potpurri/PPS-power-supply/PPS-Power-Supply.kicad_pcb

## KiCad design PPS-Power-Supply.kicad_pcb (2026-04-08)

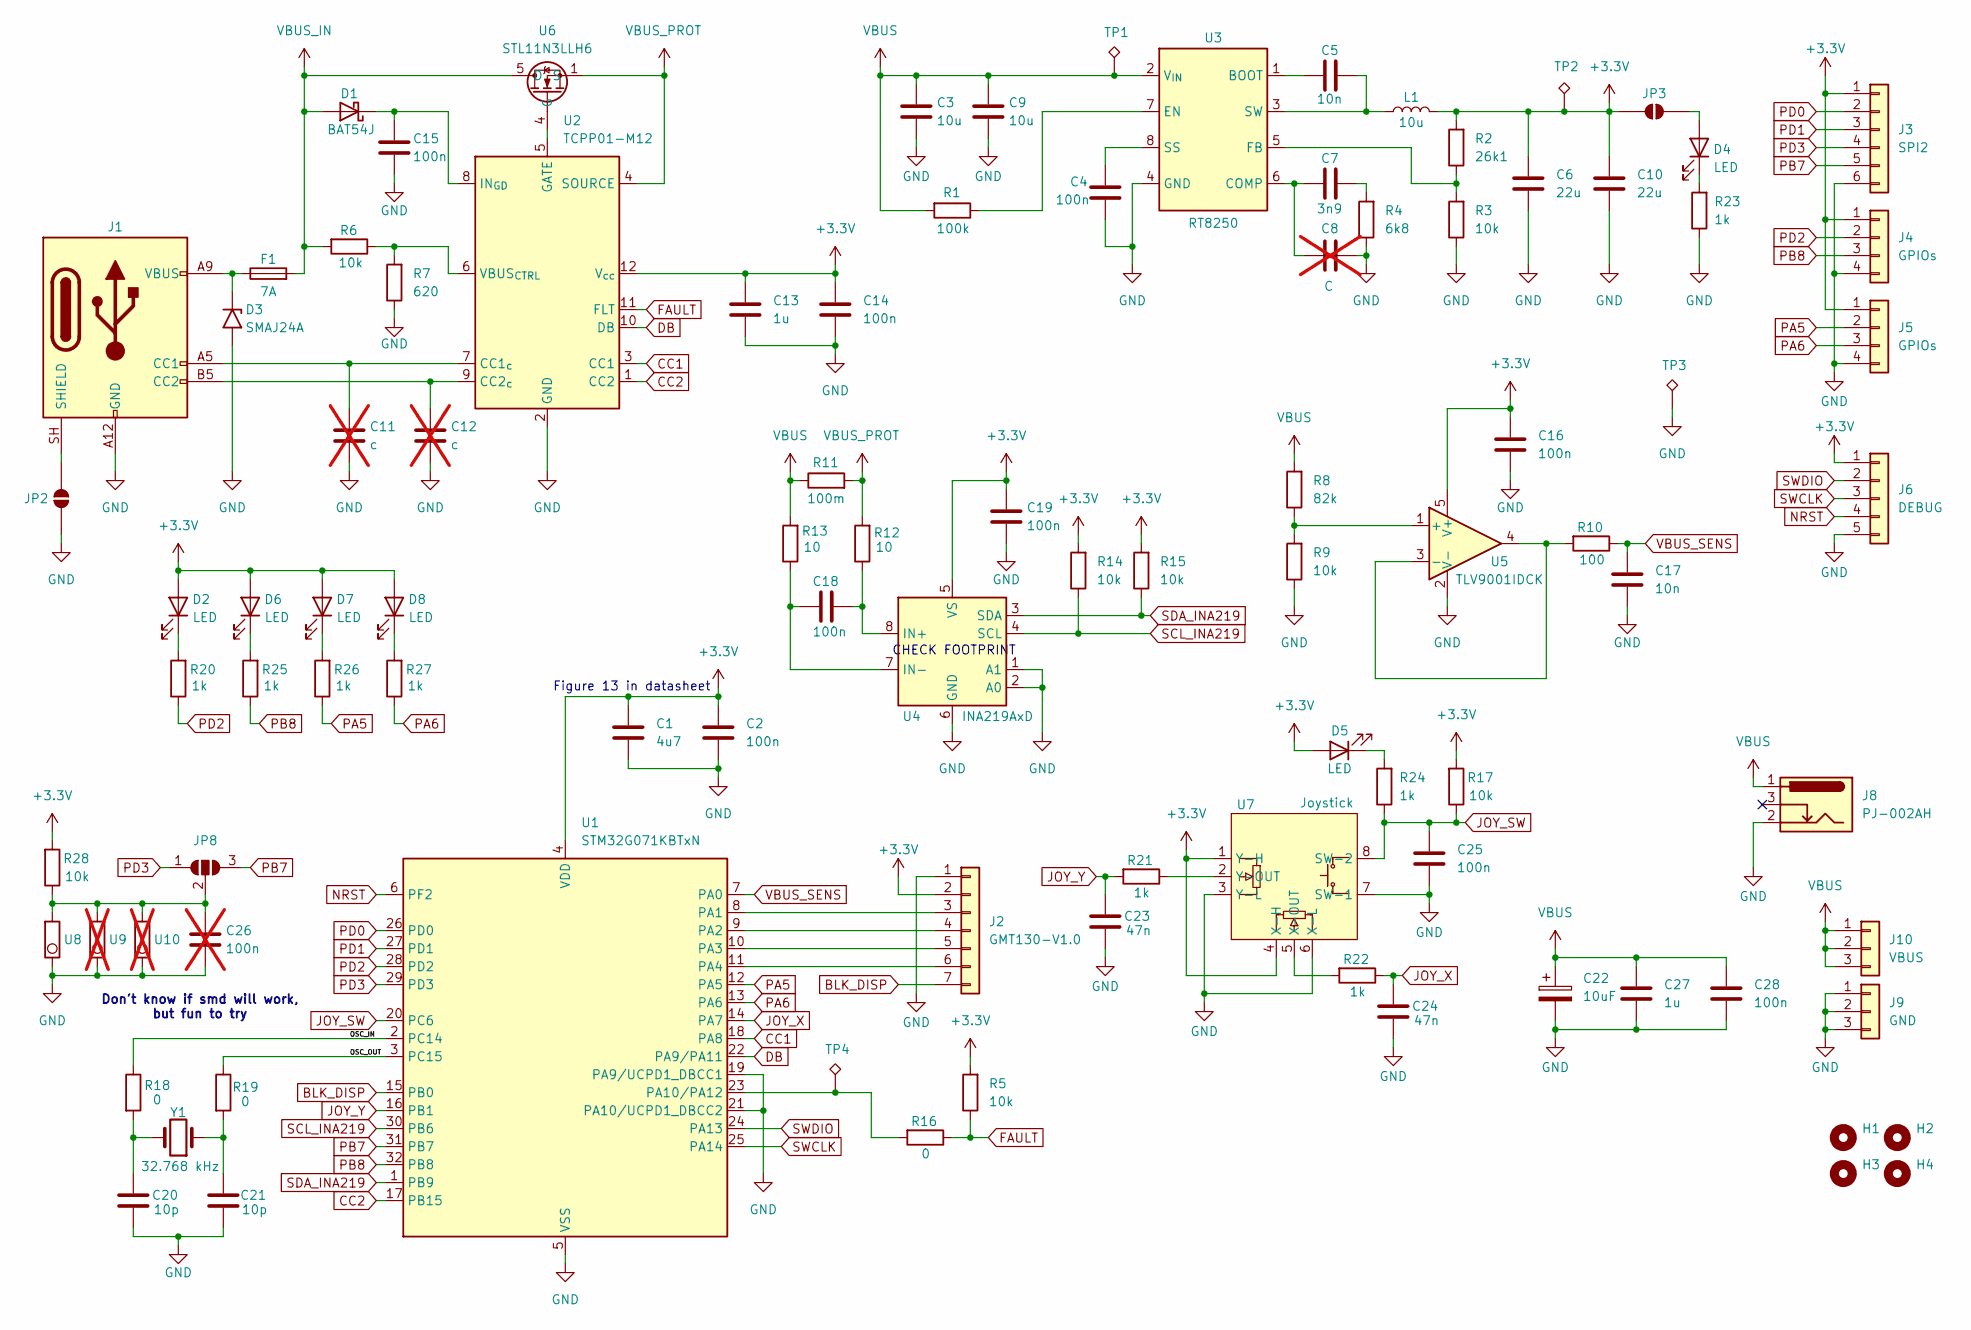
[picture p1: schematic PPS-Power-Supply.kicad_sch]

Parts:
C1: 4u7; C_0805_2012Metric
C2, C4, C14, C15, C16, C18, C19, C25, C28: 100n; C_0603_1608Metric
C3, C9: 10u; C_1206_3216Metric
C5, C17: 10n; C_0603_1608Metric
C6, C10: 22u; C_1206_3216Metric
C7: 3n9; C_0603_1608Metric
C8: C; C_0603_1608Metric; not fitted
C11, C12: c; C_0603_1608Metric; not fitted
C13, C27: 1u; C_0805_2012Metric
C20, C21: 10p; C_0603_1608Metric
C22: 10uF; CP_Elec_5x5.3
C23, C24: 47n; C_0603_1608Metric
C26: 100n; C_0603_1608Metric; not fitted
D1: BAT54J; D_SOD-323F
D2, D4, D5, D6, D7, D8: LED; LED_0805_2012Metric
D3: SMAJ24A; D_SMB
F1: 7A; Fuse_1206_3216Metric
H1, H2, H3, H4: MountingHole; MountingHole_3.2mm_M3_DIN965_Pad_TopBottom
J1: USB_C_Receptacle_PowerOnly_6P; USB_C_Receptacle_HRO_TYPE-C-31-M-17
J2: GMT130-V1.0; PinHeader_1x07_P2.54mm_Vertical
J3: SPI2; PinHeader_1x06_P2.54mm_Vertical
J4, J5: GPIOs; PinHeader_1x04_P2.54mm_Vertical
J6: DEBUG; PinHeader_1x05_P2.54mm_Vertical
J8: PJ-002AH; BarrelJack_GCT_DCJ200-10-A_Horizontal
J9: GND; PinHeader_1x03_P2.54mm_Vertical
J10: VBUS; PinHeader_1x03_P2.54mm_Vertical
JP2, JP3: SolderJumper_2_Open; SolderJumper-2_P1.3mm_Open_RoundedPad1.0x1.5mm
JP8: SolderJumper_3_Open; SolderJumper-3_P1.3mm_Open_RoundedPad1.0x1.5mm
L1: 10u; L_APV_ANR5020
R1: 100k; R_0603_1608Metric
R2: 26k1; R_0603_1608Metric
R3, R5, R6, R9, R14, R15, R17, R28: 10k; R_0603_1608Metric
R4: 6k8; R_0603_1608Metric
R7: 620; R_0603_1608Metric
R8: 82k; R_0603_1608Metric
R10: 100; R_0603_1608Metric
R11: 100m; R_2512_6332Metric
R12, R13: 10; R_0603_1608Metric
R16, R18, R19: 0; R_0805_2012Metric
R20, R21, R22, R23, R24, R25, R26, R27: 1k; R_0603_1608Metric
TP1, TP2, TP3, TP4: TestPoint_Alt; TestPoint_Pad_D1.0mm
U1: STM32G071KBTxN; LQFP-32_7x7mm_P0.8mm
U2: TCPP01-M12; QFN-12-1EP_3x3mm_P0.5mm_EP1.45x1.45mm
U3: RT8250; Texas_HSOP-8-1EP_3.9x4.9mm_P1.27mm
U4: INA219AxD; SOIC-8_3.9x4.9mm_P1.27mm
U5: TLV9001IDCK; SOT-353_SC-70-5
U6: STL11N3LLH6; POWERFLAT-3p3X3p3_STM
U7: Joystick
U8: R_Axial_DIN0411_L9.9mm_D3.6mm_P15.24mm_Horizontal
U9, U10: L_1210_3225Metric; not fitted
Y1: 32.768 kHz; Crystal_SMD_3215-2Pin_3.2x1.5mm

Connections:
+3.3V: C1.1, C2.1, C6.1, C10.1, C13.1, C14.1, C16.1, C19.1, D2.2 (A), D5.2 (A), D6.2 (A), D7.2 (A), D8.2 (A), J2.2, J3.1, J4.1, J5.1, J6.1, JP3.1 (A), L1.2, R2.2, R5.2, R14.2, R15.2, R17.2, R28.2, TP2.1 (1_1), U1.4 (VDD), U2.12 (V_{cc}), U4.5 (VS), U5.5 (V+), U7.1 (Y-H), U7.4 (X-H)
/OSC_IN: R18.1, U1.2 (PC14)
/OSC_OUT: R19.1, U1.3 (PC15)
BLK_DISP: J2.7, U1.15 (PB0)
CC1: U1.18 (PA8), U2.3 (CC1)
CC2: U1.17 (PB15), U2.1 (CC2)
DB: U1.22 (PA9/PA11), U2.10 (DB)
FAULT: R5.1, R16.1, U2.11 (FLT)
GND: C1.2, C2.2, C3.2, C4.2, C6.2, C8.2, C9.2, C10.2, C11.2, C12.2, C13.2, C14.2, C15.2, C16.2, C17.2, C19.2, C20.2, C21.2, C22.2, C23.2, C24.2, C25.2, C26.2, C27.2, C28.2, D3.2 (A2), J1.A12 (GND), J1.B12 (GND), J2.1, J3.6, J4.4, J5.4, J6.5, J8.2, J9.1, J9.2, J9.3, JP2.1 (A), R3.1, R4.1, R7.1, R9.1, R23.1, TP3.1 (1_1), U1.5 (VSS), U1.19 (PA9/UCPD1_DBCC1), U1.21 (PA10/UCPD1_DBCC2), U2.2 (GND), U2.13 (GND), U3.4 (GND), U3.9 (GND), U4.1 (A1), U4.2 (A0), U4.6 (GND), U5.2 (V-), U7.3 (Y-L), U7.6 (X-L), U7.7 (SW-1), U8., U8.1, U9., U9.1, U10., U10.1
JOY_SW: C25.1, R17.1, R24.1, U1.20 (PC6), U7.8 (SW-2)
JOY_X: C24.1, R22.1, U1.14 (PA7)
JOY_Y: C23.1, R21.2, U1.16 (PB1)
NRST: J6.4, U1.6 (PF2)
unnamed: C7.2, R4.2
unnamed: C20.1, R18.2, Y1.2
unnamed: C21.1, R19.2, Y1.1
unnamed: C15.1, D1.1 (K), U2.8 (IN_{GD})
unnamed: D2.1 (K), R20.2
unnamed: D3.1 (A1), F1.1, J1.A9 (VBUS), J1.B9 (VBUS)
unnamed: D4.2 (A), JP3.2 (B)
unnamed: D4.1 (K), R23.2
unnamed: D5.1 (K), R24.2
unnamed: D6.1 (K), R25.2
unnamed: D7.1 (K), R26.2
unnamed: D8.1 (K), R27.2
unnamed: C11.1, J1.A5 (CC1), U2.7 (CC1_{c})
unnamed: C12.1, J1.B5 (CC2), U2.9 (CC2_{c})
unnamed: J1.SH (SHIELD), JP2.2 (B)
unnamed: J2.3, U1.8 (PA1)
unnamed: J2.4, U1.9 (PA2)
unnamed: J2.5, U1.10 (PA3)
unnamed: J2.6, U1.11 (PA4)
unnamed: C26.1, JP8.2 (C), R28.1, U8., U8.2, U9., U9.2, U10., U10.2
unnamed: R16.2, TP4.1 (1_1), U1.23 (PA10/PA12)
unnamed: U2.5 (GATE), U6.4 (G)
unnamed: R6.1, R7.2, U2.6 (VBUS_{CTRL})
unnamed: C5.1, U3.1 (BOOT)
unnamed: C7.1, C8.1, U3.6 (COMP)
unnamed: R1.1, U3.7 (EN)
unnamed: R2.1, R3.2, U3.5 (FB)
unnamed: C4.1, U3.8 (SS)
unnamed: C5.2, L1.1, U3.3 (SW)
unnamed: C18.1, R12.1, U4.8 (IN+)
unnamed: C18.2, R13.1, U4.7 (IN-)
unnamed: R8.1, R9.2, U5.1 (+)
unnamed: R10.2, U5.3 (-), U5.4
unnamed: R22.2, U7.5 (X-OUT)
unnamed: R21.1, U7.2 (Y-OUT)
PA5: J5.2, R26.1, U1.12 (PA5)
PA6: J5.3, R27.1, U1.13 (PA6)
PB7: J3.5, JP8.3 (B), U1.31 (PB7)
PB8: J4.3, R25.1, U1.32 (PB8)
PD0: J3.2, U1.26 (PD0)
PD1: J3.3, U1.27 (PD1)
PD2: J4.2, R20.1, U1.28 (PD2)
PD3: J3.4, JP8.1 (A), U1.29 (PD3)
SCL_INA219: R14.1, U1.30 (PB6), U4.4 (SCL)
SDA_INA219: R15.1, U1.1 (PB9), U4.3 (SDA)
SWCLK: J6.3, U1.25 (PA14)
SWDIO: J6.2, U1.24 (PA13)
VBUS: C3.1, C9.1, C22.1, C27.1, C28.1, J8.1, J10.1, J10.2, J10.3, R1.2, R8.2, R11.1, R13.2, TP1.1 (1_1), U3.2 (V_{IN})
VBUS_IN: D1.2 (A), F1.2, R6.2, U6.5 (D), U6.6 (D), U6.7 (D), U6.8 (D)
VBUS_PROT: R11.2, R12.2, U2.4 (SOURCE), U6.1 (S), U6.2 (S), U6.3 (S)
VBUS_SENS: C17.1, R10.1, U1.7 (PA0)

Notes on the sheet:
Don't know if smd will work, but fun to try
CHECK FOOTPRINT
Figure 13 in datasheet

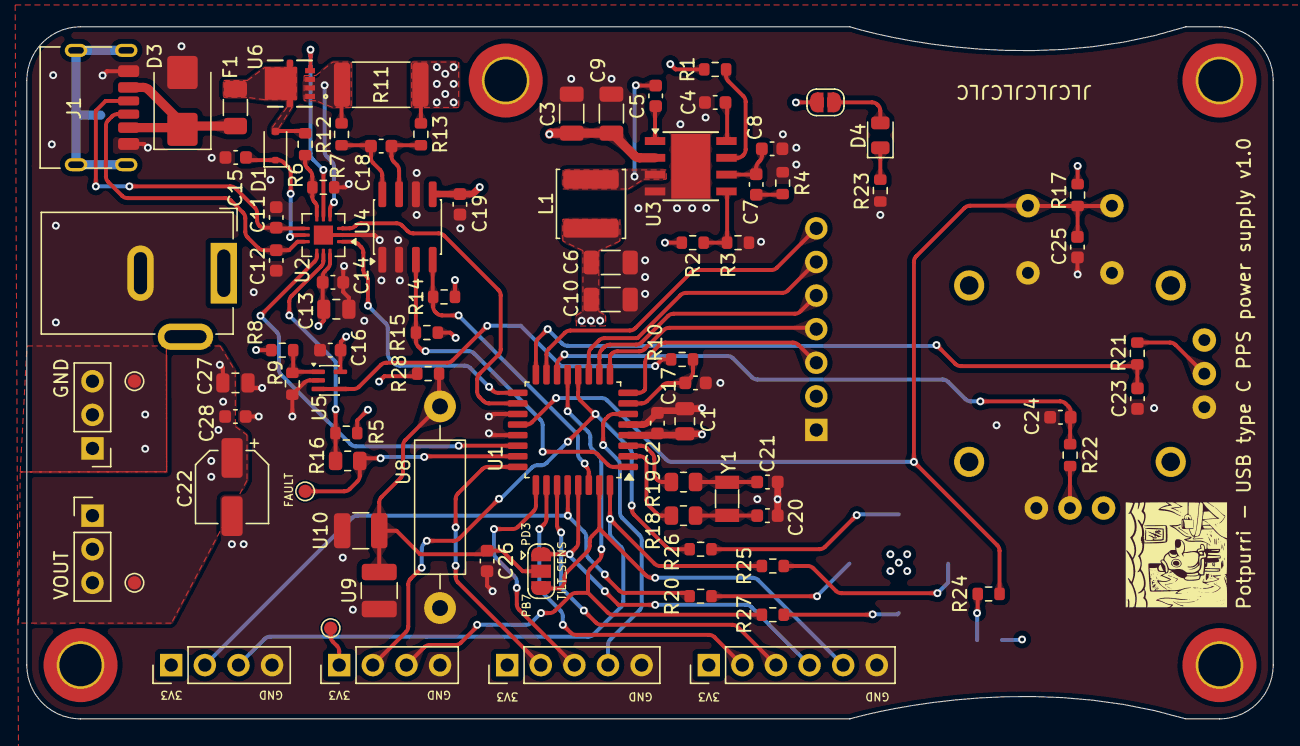
[picture p2: board PPS-Power-Supply.kicad_pcb from above]

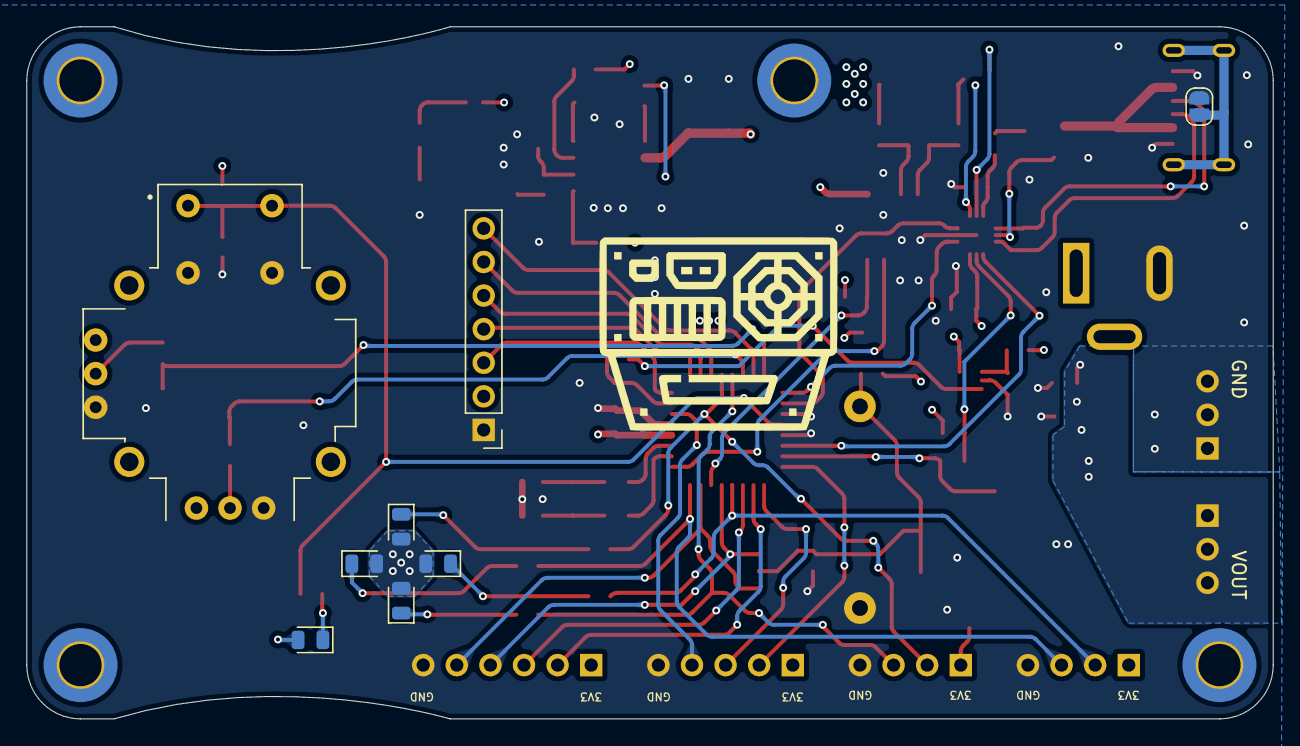
[picture p3: board PPS-Power-Supply.kicad_pcb from below]

Board: 4 copper layers, 94.2 x 52.3 mm, 97 parts (8 on the bottom side), 64 nets.
