potpurri/PPS-power-supply/FW/PPS-Power-Supply.ioc

Mcu.UserName=STM32G071KBTxN
PA0.GPIO_Label=VBUS_SENS
PA0.Signal=ADC1_IN0
PA1.GPIO_Label=SCK_DISP
PA1.Signal=SPI1_SCK
PA10.Signal=UCPD1_DBCC2
PA13.Signal=SYS_SWDIO
PA14-BOOT0.Signal=SYS_SWCLK
PA2.GPIO_Label=SDA_DISP
PA2.Signal=SPI1_MOSI
PA3.GPIO_Label=RES_DISP
PA3.Signal=GPIO_Output
PA4.GPIO_Label=DC_DISP
PA4.Signal=GPIO_Output
PA7.GPIO_Label=JOY_X
PA7.Signal=ADC1_IN7
PA8.Signal=UCPD1_CC1
PA9.Signal=UCPD1_DBCC1
PB0.GPIO_Label=BLK_DISP
PB0.Signal=S_TIM3_CH3
PB1.GPIO_Label=JOY_Y
PB1.Signal=ADC1_IN9
PB15.Signal=UCPD1_CC2
PB6.GPIO_Label=SCL_INA219
PB6.Signal=I2C1_SCL
PB9.GPIO_Label=SDA_INA219
PB9.Signal=I2C1_SDA
PC6.GPIO_Label=JOY_SW
PC6.Signal=GPIO_Input
